Tinkerforge/imu-brick/software/examples/labview/Example Callback.vi.png

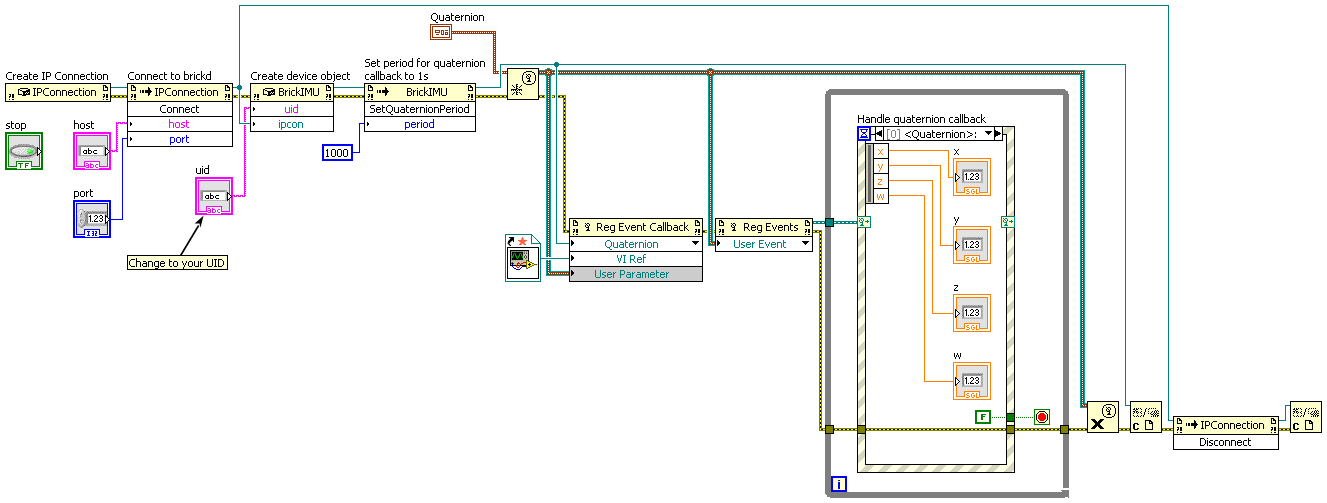
software/examples/labview/Example Callback.vi.png
