Tinkerforge/imu-brick/software/examples/labview/Example Simple.vi.png

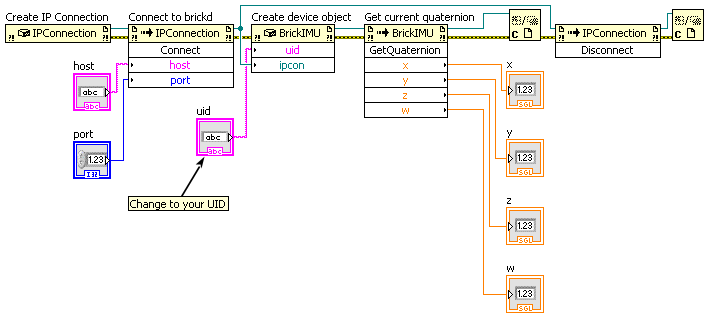
software/examples/labview/Example Simple.vi.png
