Tinkerforge/imu-brick/hardware/imu-schematic.pdf

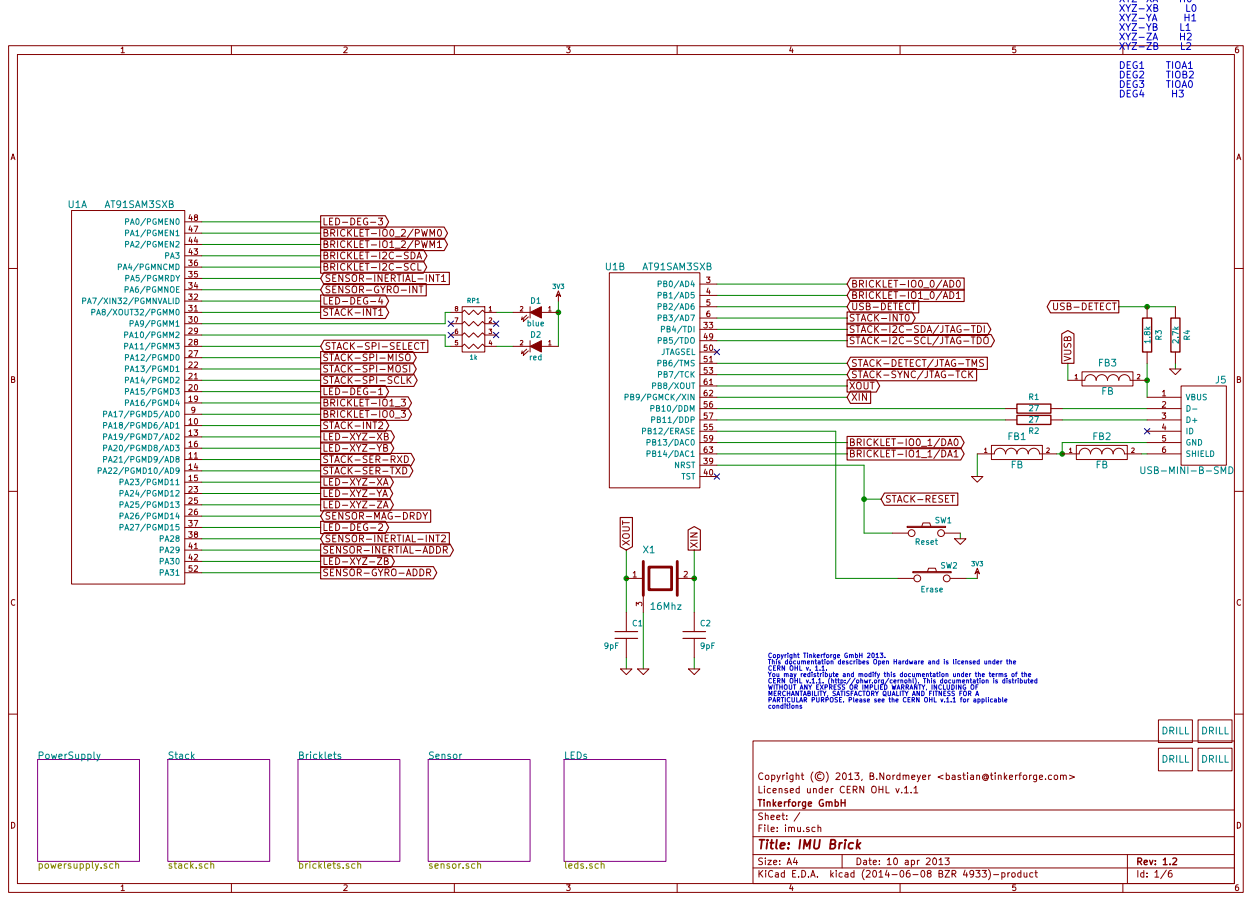
[picture p3: page 1]

XYZ-XA H0 XYZ-XB L0 XYZ-YA H1 XYZ-YB L1 XYZ-ZA H2 XYZ-ZB L2 DEG1 TIOA1

BRICKLET-IO0_2/PWM0 Bricklets bricklets.sch
BRICKLET-IO1_2/PWM1
BRICKLET-I2C-SDA
BRICKLET-I2C-SCL
SENSOR-INERTIAL-INT1
3V3 BRICKLET-IO1_3
SENSOR-GYRO-INT
1k LED-DEG-4

STACK-I2C-SDA/JTAG-TDI
STACK-I2C-SCL/JTAG-TDO

STACK-DETECT/JTAG-TMS
STACK-SYNC/JTAG-TCK
XOUT
XIN

BRICKLET-IO0_3
STACK-INT2
LED-XYZ-XB
LED-XYZ-YB
STACK-SER-RXD
STACK-SER-TXD
LED-XYZ-XA
LED-XYZ-YA
LED-XYZ-ZA
LED-DEG-2
SENSOR-INERTIAL-INT2
leds.sch SENSOR-INERTIAL-ADDR
LED-XYZ-ZB
SENSOR-GYRO-ADDR

Copyright Tinkerforge GmbH 2013. This documentation describes Open Hardware and is licensed under the CERN OHL v. 1.1. You may redistribute and modify this documentation under the terms of the CERN OHL v.1.1. (http://ohwr.org/cernohl). This documentation is distributed WITHOUT ANY EXPRESS OR IMPLIED WARRANTY, INCLUDING OF MERCHANTABILITY, SATISFACTORY QUALITY AND FITNESS FOR A

PARTICULAR PURPOSE. Please see the CERN OHL v.1.1 for applicable
conditions

Licensed under CERN OHL v.1.1 Copyright (©) 2013, B.Nordmeyer <bastian@tinkerforge.com>

File: imu.sch Sheet: / Tinkerforge GmbH

Id: 1/6 Title: IMU Brick

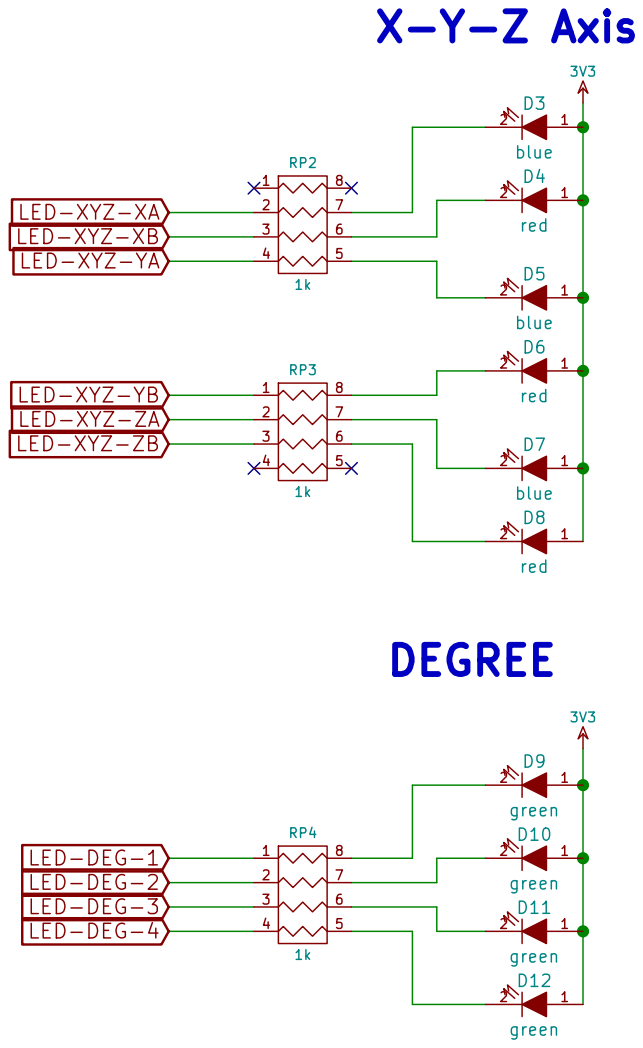
[picture p4: page 2]

Licensed under CERN OHL v.1.1 Copyright (©) 2013, B.Nordmeyer <bastian@tinkerforge.com>

File: leds.sch Sheet: /LEDs/ Tinkerforge GmbH

Id: 2/6 Title: IMU Brick

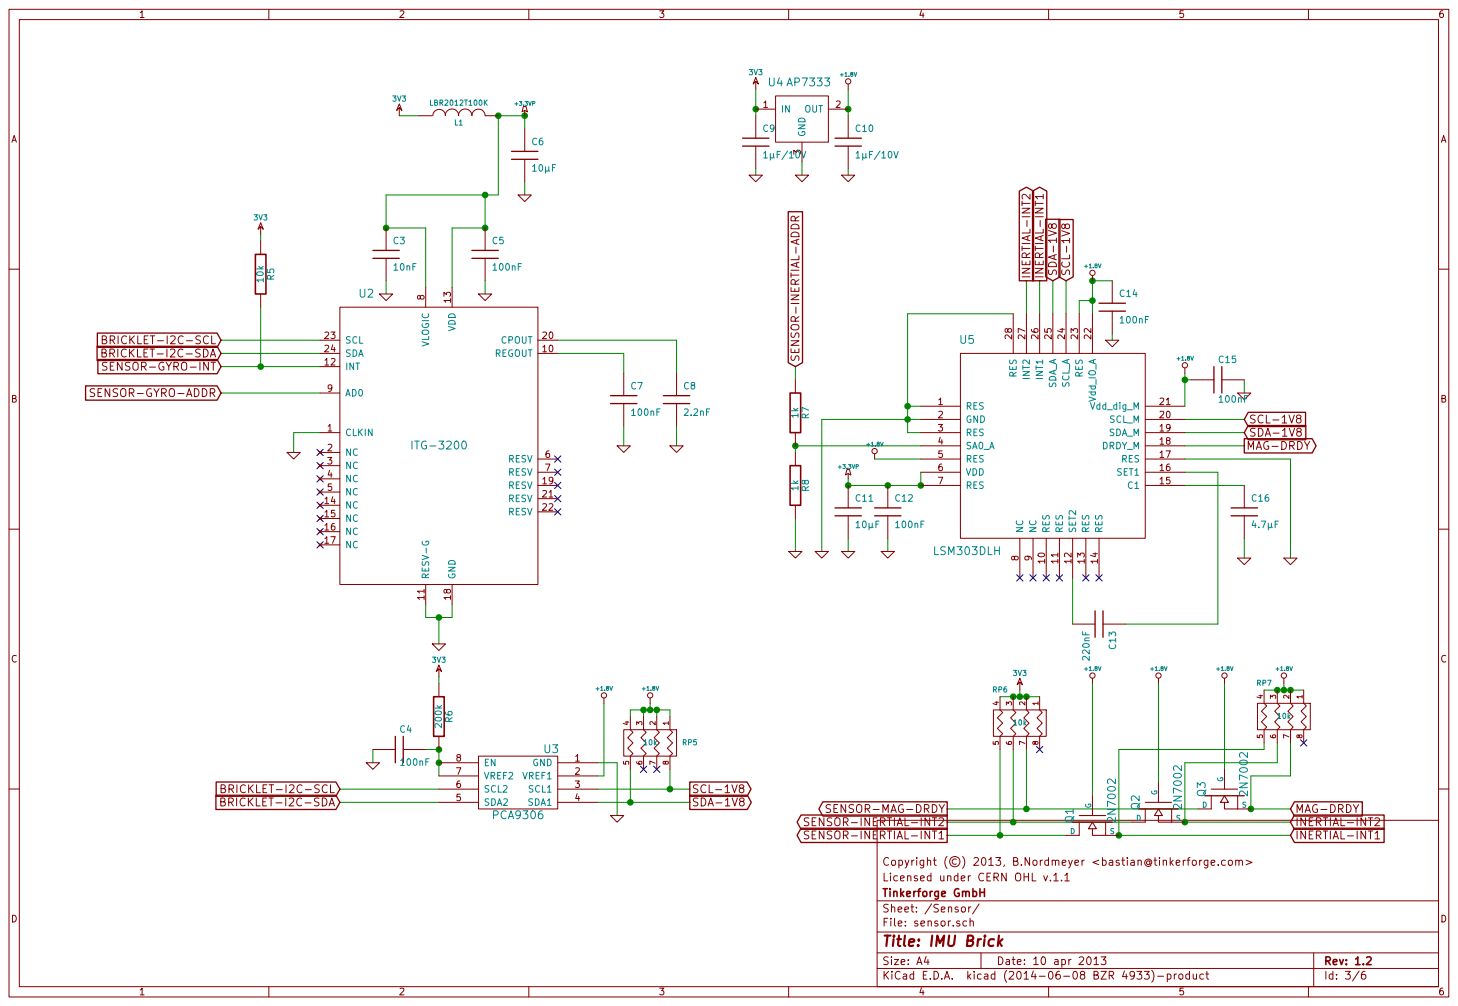
[picture p5: page 3]

8 AD0 9 REGOUT 10 CPOUT 20 RESV-G 11 RESV 21

9 RES 10 SCL_M 20 RES 11 Vdd_dig_M 21 SET2 12 Vdd_IO_A 22 RES 13 RES 23 RES 14 SCL_A 24 C1 15 SDA_A 25 SET1 16 INT1 26 RES 17 INT2 27 DRDY_M 18 RES 28 SDA_M 19 U5

Licensed under CERN OHL v.1.1 Copyright (©) 2013, B.Nordmeyer <bastian@tinkerforge.com>

File: sensor.sch Sheet: /Sensor/ Tinkerforge GmbH

Id: 3/6 Title: IMU Brick

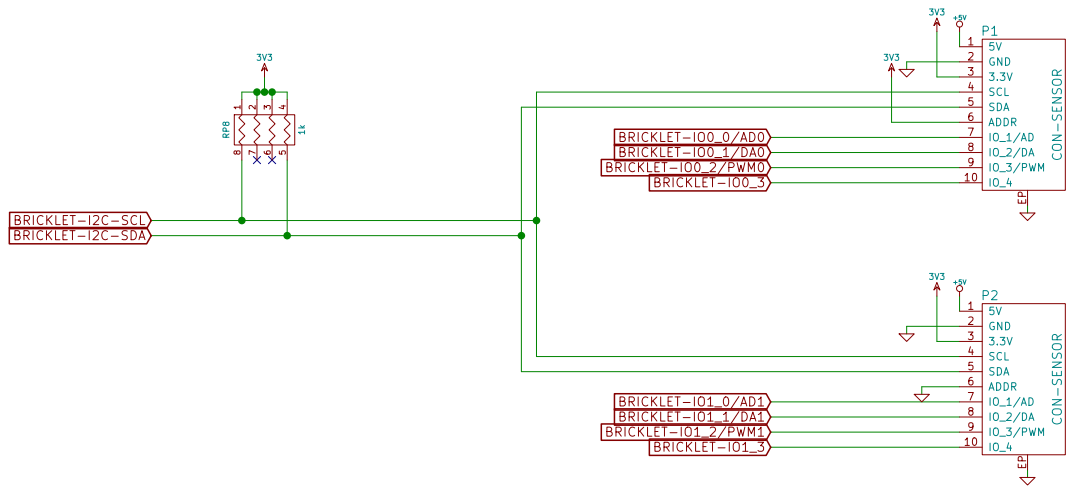
[picture p6: page 4]

File: bricklets.sch Sheet: /Bricklets/ Tinkerforge GmbH

Id: 4/6 Title: IMU Brick

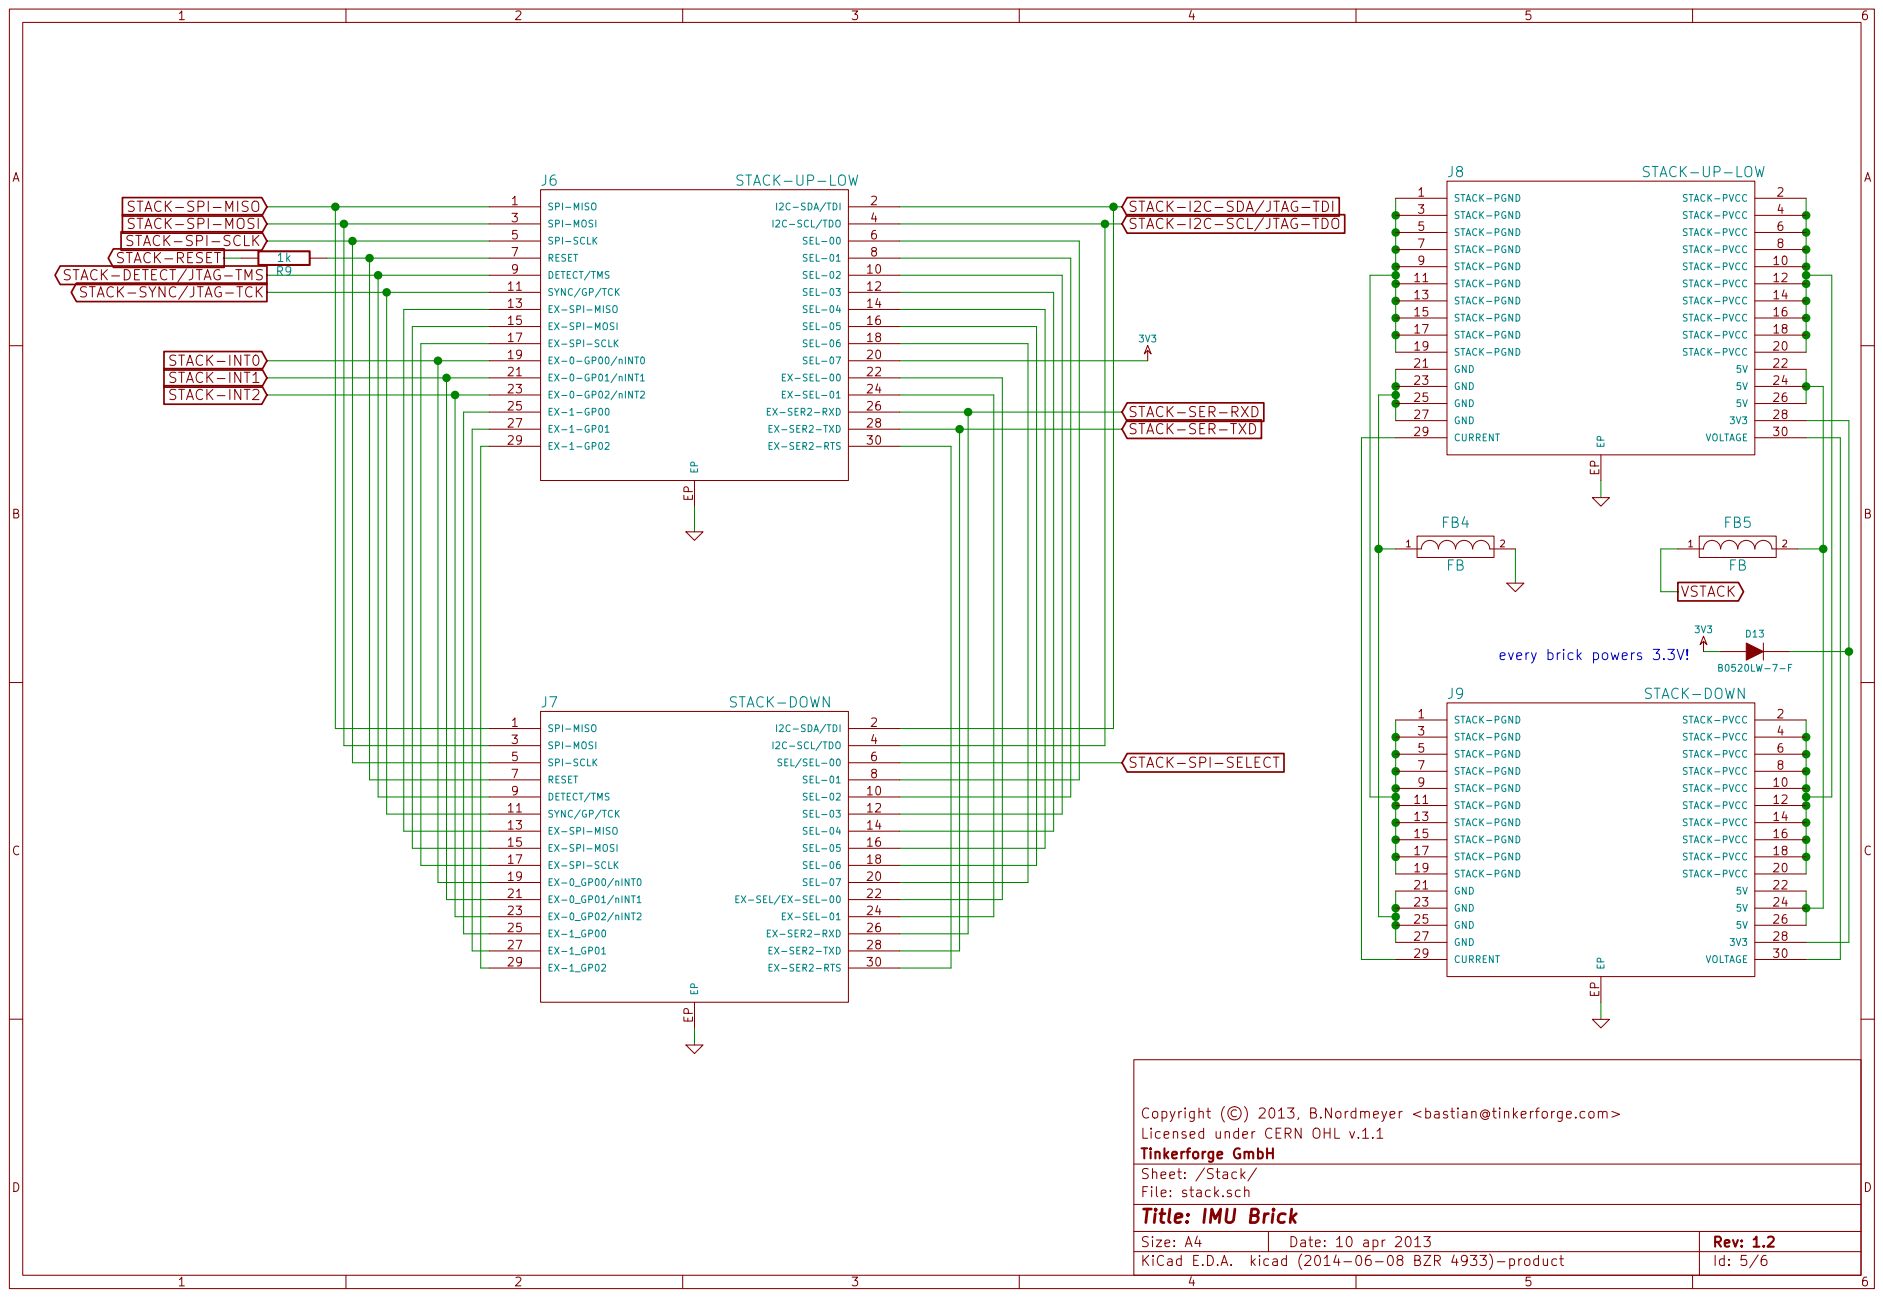
[picture p7: page 5]

STACK-SPI-MISO
STACK-SPI-MOSI
STACK-SPI-SCLK
STACK-RESET
STACK-DETECT/JTAG-TMS
STACK-SYNC/JTAG-TCK

STACK-I2C-SDA/JTAG-TDI
STACK-I2C-SCL/JTAG-TDO

Licensed under CERN OHL v.1.1 Copyright (©) 2013, B.Nordmeyer <bastian@tinkerforge.com>

File: stack.sch Sheet: /Stack/ Tinkerforge GmbH

Id: 5/6 Title: IMU Brick

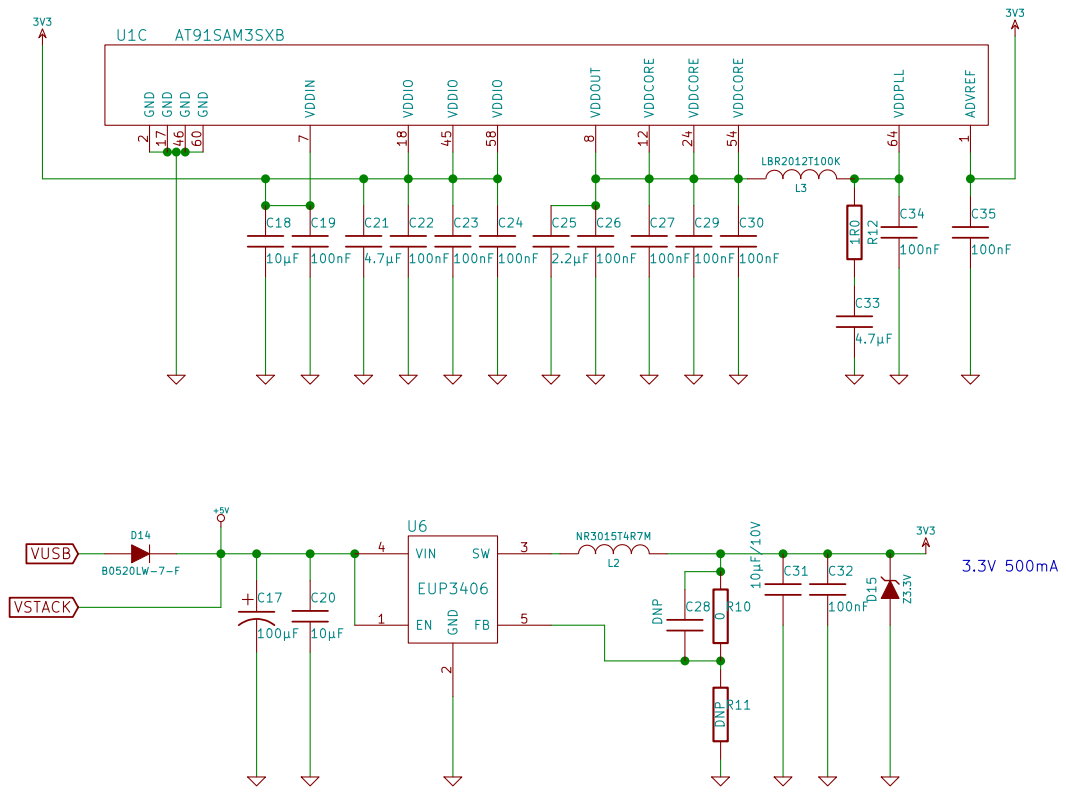
[picture p8: page 6]

8 GND 60 VDDCORE 12 VDDCORE 24 VDDCORE 54 VDDPLL 64 VDDIO 45 GND 46 GND 17 VDDIO 18 VDDIO 58

Licensed under CERN OHL v.1.1 Copyright (©) 2013, B.Nordmeyer <bastian@tinkerforge.com>

Tinkerforge GmbH
Sheet: /PowerSupply/
File: powersupply.sch
Id: 6/6 Title: IMU Brick

D Date: 10 apr 2013
