Tinkerforge/imu-brick/hardware/bricklets.sch

## KiCad design hardware/bricklets.sch (2014-07-07)

Schematic: bricklets.sch

Parts:
P1, P2: CON-SENSOR
RP8: 1k; 0603X4
