Tinkerforge/imu-brick/hardware/imu.sch

## KiCad design hardware/imu.sch (2014-07-07)

Schematic: imu.sch

Parts:
C1, C2: 9pF; 0402
D1: blue; D0603
D2: red; D0603
FB1, FB2, FB3: FB; 0603
J1, J2, J3, J4: DRILL; DRILL_NP
J5: USB-MINI-B-SMD
R1, R2: 27; 0402
R3: 1.8k; 0402
R4: 2.7k; 0402
RP1: 1k; 0603X4
SW1: Reset; TACT-SWITCH
SW2: Erase; TACT-SWITCH
U1: AT91SAM3SXB; LQFP64
X1: 16Mhz; CRYSTAL_3225

Notes on the sheet:
Copyright Tinkerforge GmbH 2013. This documentation describes Open Hardware and is licensed under the CERN OHL v. 1.1. You may redistribute and modify this documentation under the terms of the CERN OHL v.1.1. (http://ohwr.org/cernohl). This documentation is distributed WITHOUT ANY EXPRESS OR IMPLIE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
XYZ-XA H0 XYZ-XB L0 XYZ-YA H1 XYZ-YB L1 XYZ-ZA H2 XYZ-ZB L2 DEG1 TIOA1 DEG2 TIOB2 DEG3 TIOA0 DEG4 H3
