Tinkerforge/imu-brick/hardware/leds.sch

## KiCad design hardware/leds.sch (2014-07-07)

Schematic: leds.sch

Parts:
D3, D5, D7: blue; D0603
D4, D6, D8: red; D0603
D9, D10, D11, D12: green; D0603
RP2, RP3, RP4: 1k; 0603X4

Notes on the sheet:
DEGREE
X-Y-Z Axis
