Tinkerforge/imu-brick/hardware/powersupply.sch

## KiCad design hardware/powersupply.sch (2014-07-07)

Schematic: powersupply.sch

Parts:
C17: 100µF; 3528-21
C18, C20: 10µF; 0805
C19, C22, C23, C24, C26, C27, C29, C30, C32, C34, C35: 100nF; 0402
C21, C33: 4.7µF; 0603
C25: 2.2µF; 0603
C28: DNP; 0402
C31: 10µF/10V; 0805
D14: B0520LW-7-F; SOD-123
D15: Z3.3V; SOD-123
L2: NR3015T4R7M; NR3030
L3: LBR2012T100K; 0805
R10: 0; 0603
R11: DNP; 0603
R12: 1R0; 0402
U1: AT91SAM3SXB
U6: EUP3406; SOT23-5

Notes on the sheet:
3.3V 500mA
