Tinkerforge/imu-brick/hardware/sensor.sch

## KiCad design hardware/sensor.sch (2014-07-07)

Schematic: sensor.sch

Parts:
C3: 10nF; 0402
C4, C5, C7, C12, C14, C15: 100nF; 0402
C6, C11: 10µF; 0805
C8: 2.2nF; 0402
C9, C10: 1µF/10V; 0402
C13: 220nF; 0603
C16: 4.7µF; 0603
L1: LBR2012T100K; 0805
Q1, Q2, Q3: 2N7002; SOT23GDS
R5: 10k; 0402
R6: 200k; 0402
R7, R8: 1k; 0402
RP5, RP6, RP7: 10k; 0603X4
U2: ITG-3200; QFN-24-4x4
U3: PCA9306; TSSOP8_3
U4: AP7333; SOT23-3
U5: LSM303DLH; LGA-28
