Tinkerforge/imu-brick/hardware/stack.sch

## KiCad design hardware/stack.sch (2014-07-07)

Schematic: stack.sch

Parts:
D13: B0520LW-7-F; SOD-123
FB4, FB5: FB; 0603
J6, J8: STACK-UP-LOW; BTB08-ACS-TOP
J7, J9: STACK-DOWN; BTB08-ACS-BTM
R9: 1k; 0402

Notes on the sheet:
every brick powers 3.3V!
