Tinkerforge/imu-brick/software/src/config.h

/* imu-brick
 * Copyright (C) 2010-2012 Olaf Lüke <olaf@tinkerforge.com>
 *
 * config.h: IMU-Brick specific configuration
 *
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
 * You should have received a copy of the GNU Lesser General Public
 * License along with this library; if not, write to the
 * Free Software Foundation, Inc., 59 Temple Place - Suite 330,
 * Boston, MA 02111-1307, USA.
 */

#ifndef CONFIG_H
#define CONFIG_H

#include "communication.h"
#include "bricklib/drivers/board/sam3s/SAM3S.h"

#include "imu.h"

#define BRICK_FIRMWARE_VERSION_MAJOR 2
#define BRICK_FIRMWARE_VERSION_MINOR 3
#define BRICK_FIRMWARE_VERSION_REVISION 9

#define BRICK_HARDWARE_VERSION_MAJOR 1
#define BRICK_HARDWARE_VERSION_MINOR 1
#define BRICK_HARDWARE_VERSION_REVISION 0

#define BRICK_DEVICE_IDENTIFIER 16

// ************** DEBUG SETTINGS **************
#define DEBUG_SPI_STACK 1
#define DEBUG_I2C_EEPROM 1
#define DEBUG_STARTUP 1
#define DEBUG_BRICKLET 1
#define DEBUG_IMU 1
//#define PROFILING
//#define PROFILING_TIME 100 // After how many seconds profiling is printed

#define DISABLE_JTAG_ON_STARTUP
//#define LOGGING_SERIAL
//#define LOGGING_LEVEL LOGGING_DEBUG
#define LOGGING_LEVEL LOGGING_NONE


// ************** BRICK SETTINGS **************

// Frequencies
#define BOARD_MCK      64000000 // Frequency of brick
#define BOARD_MAINOSC  16000000 // Frequency of oscillator
#define BOARD_ADC_FREQ 16000000 // Frequency of ADC
#define BOARD_OSC_EXTERNAL      // Use external oscillator

#define BRICK_HAS_CO_MCU_SUPPORT

// UART for console output (printf)
#define PIN_CONSOLE_RXD  {1 << 21, PIOA, ID_PIOA, PIO_PERIPH_A, PIO_DEFAULT}
#define PIN_CONSOLE_TXD  {1 << 22, PIOA, ID_PIOA, PIO_PERIPH_A, PIO_DEFAULT}

#define CONSOLE_BAUDRATE 115200
#define CONSOLE_USART    USART1
#define CONSOLE_ID       ID_USART1
#define CONSOLE_PINS     {PIN_CONSOLE_RXD, PIN_CONSOLE_TXD}

#define PINS_UART        {PIN_CONSOLE_RXD, PIN_CONSOLE_TXD}

// TWI
// TWI version
#define TWI_V3XX

// TWI stack definitions (for reading of eeproms from Bricks in stack)
#define TWI_STACK           TWI1
#define PIN_TWI_TWD_STACK   {1 << 4, PIOB, ID_PIOB, PIO_PERIPH_A, PIO_DEFAULT}
#define PIN_TWI_TWCK_STACK  {1 << 5, PIOB, ID_PIOB, PIO_PERIPH_A, PIO_DEFAULT}
#define PINS_TWI_STACK      PIN_TWI_TWD_STACK, PIN_TWI_TWCK_STACK

// TWI bricklet definitions (for bricklets, spi select and brick specific
//                           functions)
#define TWI_BRICKLET           TWI0
#define PIN_TWI_TWD_BRICKLET   {1 << 3, PIOA, ID_PIOA, PIO_PERIPH_A, PIO_DEFAULT}
#define PIN_TWI_TWCK_BRICKLET  {1 << 4, PIOA, ID_PIOA, PIO_PERIPH_A, PIO_DEFAULT}
#define PINS_TWI_BRICKLET      PIN_TWI_TWD_BRICKLET, PIN_TWI_TWCK_BRICKLET

// USB
// USB VBUS monitoring pin for USB plug and play
#define PIN_USB_DETECT  {1 << 2, PIOB, ID_PIOB, PIO_INPUT, PIO_DEFAULT}
// USB product descriptor (name of brick)
#define PRODUCT_DESCRIPTOR { \
	USBStringDescriptor_LENGTH(9), \
    USBGenericDescriptor_STRING, \
    USBStringDescriptor_UNICODE('I'), \
    USBStringDescriptor_UNICODE('M'), \
    USBStringDescriptor_UNICODE('U'), \
    USBStringDescriptor_UNICODE(' '), \
    USBStringDescriptor_UNICODE('B'), \
    USBStringDescriptor_UNICODE('r'), \
    USBStringDescriptor_UNICODE('i'), \
    USBStringDescriptor_UNICODE('c'), \
    USBStringDescriptor_UNICODE('k') \
}


// SPI
#define PIN_SPI_MISO        {1 << 12, PIOA, ID_PIOA, PIO_PERIPH_A, PIO_DEFAULT}
#define PIN_SPI_MOSI        {1 << 13, PIOA, ID_PIOA, PIO_PERIPH_A, PIO_DEFAULT}
#define PIN_SPI_SPCK        {1 << 14, PIOA, ID_PIOA, PIO_PERIPH_A, PIO_DEFAULT}

#define PINS_SPI            PIN_SPI_MISO, PIN_SPI_MOSI, PIN_SPI_SPCK

#define PIN_SPI_SELECT_SLAVE  {1 << 11, PIOA, ID_PIOA, PIO_PERIPH_A, PIO_DEFAULT}

// LED
#define PIN_LED_STD_BLUE    {1 << 9, PIOA, ID_PIOA, PIO_OUTPUT_1, PIO_DEFAULT}
#define PIN_LED_STD_RED     {1 << 10, PIOA, ID_PIOA, PIO_OUTPUT_1, PIO_DEFAULT}
#define PINS_STD_LED        PIN_LED_STD_BLUE, PIN_LED_STD_RED

#define LED_STD_BLUE        0
#define LED_STD_RED         1


// Brick Detect
// Set low by master
// TODO: Change name to STACK_DETECT
#define PIN_DETECT        {1 << 6, PIOB, ID_PIOB, PIO_OUTPUT_0, PIO_DEFAULT}



// ************** INTERRUPT PRIORITIES ***********
#define PRIORITY_EEPROM_MASTER_TWI0  1
#define PRIORITY_EEPROM_SLAVE_TWI1   1
#define PRIORITY_STACK_SLAVE_SPI     6
#define PRIORITY_PROFILING_TC0       0

// ************** BRICKLET SETTINGS **************

// Number of bricklet ports
#define BRICKLET_NUM 2

// BRICKLET A
#define BRICKLET_A_ADDRESS 84
#define BRICKLET_A_ADC_CHANNEL 4

#define BRICKLET_A_PIN_1_AD   {1 << 0, PIOB, ID_PIOB, PIO_INPUT, PIO_DEFAULT}
#define BRICKLET_A_PIN_2_DA   {1 << 13, PIOB, ID_PIOB, PIO_INPUT, PIO_DEFAULT}
#define BRICKLET_A_PIN_3_PWM  {1 << 1, PIOA, ID_PIOA, PIO_INPUT, PIO_DEFAULT}
#define BRICKLET_A_PIN_4_IO   {1 << 17, PIOA, ID_PIOA, PIO_INPUT, PIO_DEFAULT}
#define BRICKLET_A_PIN_SELECT {0, 0, 0, 0, 0}

// BRICKLET B
#define BRICKLET_B_ADDRESS 80
#define BRICKLET_B_ADC_CHANNEL 5

#define BRICKLET_B_PIN_1_AD   {1 << 1, PIOB, ID_PIOB, PIO_INPUT, PIO_DEFAULT}
#define BRICKLET_B_PIN_2_DA   {1 << 14, PIOB, ID_PIOB, PIO_INPUT, PIO_DEFAULT}
#define BRICKLET_B_PIN_3_PWM  {1 << 2, PIOA, ID_PIOA, PIO_INPUT, PIO_DEFAULT}
#define BRICKLET_B_PIN_4_IO   {1 << 16, PIOA, ID_PIOA, PIO_INPUT, PIO_DEFAULT}
#define BRICKLET_B_PIN_SELECT {0, 0, 0, 0, 0}

// *************** IMU DEBUGGING **************
#if(DEBUG_IMU)
#define logimud(str, ...) do{logd("imu: " str, ##__VA_ARGS__);}while(0)
#define logimui(str, ...) do{logi("imu: " str, ##__VA_ARGS__);}while(0)
#define logimuw(str, ...) do{logw("imu: " str, ##__VA_ARGS__);}while(0)
#define logimue(str, ...) do{loge("imu: " str, ##__VA_ARGS__);}while(0)
#define logimuf(str, ...) do{logf("imu: " str, ##__VA_ARGS__);}while(0)
#else
#define logimud(str, ...) {}
#define logimui(str, ...) {}
#define logimuw(str, ...) {}
#define logimue(str, ...) {}
#define logimuf(str, ...) {}
#endif
#endif

// *************** IMU LED PINS ***************
#define PIN_LED_X_N  {1 << 19, PIOA, ID_PIOA, PIO_PERIPH_B, PIO_DEFAULT}
#define PIN_LED_X_P  {1 << 23, PIOA, ID_PIOA, PIO_PERIPH_B, PIO_DEFAULT}
#define PIN_LED_Y_N  {1 << 20, PIOA, ID_PIOA, PIO_PERIPH_B, PIO_DEFAULT}
#define PIN_LED_Y_P  {1 << 24, PIOA, ID_PIOA, PIO_PERIPH_B, PIO_DEFAULT}
#define PIN_LED_Z_N  {1 << 25, PIOA, ID_PIOA, PIO_PERIPH_B, PIO_DEFAULT}
#define PIN_LED_Z_P  {1 << 30, PIOA, ID_PIOA, PIO_PERIPH_A, PIO_DEFAULT}

#define PINS_LED_XYZ   PIN_LED_X_P, PIN_LED_X_N, PIN_LED_Y_P, \
                       PIN_LED_Y_N, PIN_LED_Z_P, PIN_LED_Z_N

#define PIN_LED_DEG_0  {1 << 15, PIOA, ID_PIOA, PIO_PERIPH_B, PIO_DEFAULT}
#define PIN_LED_DEG_1  {1 << 27, PIOA, ID_PIOA, PIO_PERIPH_B, PIO_DEFAULT}
#define PIN_LED_DEG_2  {1 << 0, PIOA, ID_PIOA, PIO_PERIPH_B, PIO_DEFAULT}
#define PIN_LED_DEG_3  {1 << 7, PIOA, ID_PIOA, PIO_PERIPH_B, PIO_DEFAULT}

#define PINS_LED_DEG   PIN_LED_DEG_0, PIN_LED_DEG_1, \
                       PIN_LED_DEG_2, PIN_LED_DEG_3

#define PINS_IMU_LED   PINS_LED_XYZ, PINS_LED_DEG
#define PINS_LED       PINS_STD_LED, PINS_IMU_LED

#define LED_X_P      0
#define LED_X_N      1
#define LED_Y_P      2
#define LED_Y_N      3
#define LED_Z_P      4
#define LED_Z_N      5

#define LED_DEG_0    6
#define LED_DEG_1    7
#define LED_DEG_2    8
#define LED_DEG_3    9

// *************** ITG-3200 PINS ***************
#define PIN_ITG_ADDR     {1 << 31, PIOA, ID_PIOA, PIO_OUTPUT_0, PIO_DEFAULT}
#define PIN_ITG_INT      {1 << 6, PIOA, ID_PIOA, PIO_INPUT, PIO_DEFAULT}

#define PINS_ITG         PIN_ITG_ADDR, PIN_ITG_INT

// *************** LSM303 PINS *****************
#define PIN_LSM_ADDR     {1 << 29, PIOA, ID_PIOA, PIO_OUTPUT_0, PIO_DEFAULT}
#define PIN_LSM_INT1     {1 << 5, PIOA, ID_PIOA, PIO_INPUT, PIO_DEFAULT}
#define PIN_LSM_INT2     {1 << 28, PIOA, ID_PIOA, PIO_INPUT, PIO_DEFAULT}
#define PIN_LSM_MAG_RDY  {1 << 26, PIOA, ID_PIOA, PIO_INPUT, PIO_DEFAULT}

#define PINS_LSM         PIN_LSM_ADDR, PIN_LSM_INT1, \
                         PIN_LSM_INT2, PIN_LSM_MAG_RDY

#define TWI_IMU          TWI0


// *************** Stack interrupt pins *********
#define PIN_STACK_INT0   {1 << 3, PIOB, ID_PIOB, PIO_INPUT, PIO_DEFAULT}
#define PIN_STACK_INT1   {1 << 8, PIOA, ID_PIOA, PIO_INPUT, PIO_DEFAULT}
#define PIN_STACK_INT2   {1 << 18, PIOA, ID_PIOA, PIO_INPUT, PIO_DEFAULT}

#define PINS_STACK       PIN_STACK_INT0, PIN_STACK_INT1, PIN_STACK_INT2
