Tinkerforge/imu-brick/(commit log)

2012-03-02 Use quaternion instead of magnetometer for direction leds
2012-03-05 Fix bug with timeouts on windows (through bricklib)
    [config.h]
2012-03-11 Fix bug with ADC calibration readout (through bricklib)
    [config.h]
2012-05-31 Add imu calibration software (magnetometer code still missing)
    [calibration.py]
2012-06-03 Repair wrong defines (see issue #1 on github)
    [imu.h]
2012-06-03 Change IMU Brick version to 1.0.5
2012-06-29 Add get_temperature and reset function (through bricklib)
    [config.h]
2012-07-13 Fix profiling (bricklib issue #2)
    [imu.c]
2012-09-20 Set Interrupt pins to input default (otherwise they can interfere with WIFI)
    [calibration.py, config.h, main.c]
2012-11-30 Fix compile error in last commit
    [communication.c]
2013-01-07 Use portEND_SWITCHING_ISR to return from interrupt
2013-01-09 Use specific device object for callbacks
2013-04-11 Convert IMU calibration scripts to protocol v2
2013-04-11 Add watchdog timer (restart after 16s of "deadlock")
2013-05-13 Add orientation calculation on/off API, make i2c communication synchronous
2013-06-27 Use tick_task to detect usb connect/disconnect instead of interrupt (through bricklib)
2014-04-02 perl: Unify print style
2014-06-12 change voltage divider resistor values
    [bricklets.sch, imu.brd, imu.sch, leds.sch, powersupply.sch, sensor.sch, stack.sch]
2014-09-25 Add SPI DMA defines
2014-11-25 Use new SPI protocol
2015-05-13 Implement set/get acceleration/magnetometer range
2015-06-22 matlab: Unify printing style in examples
2015-08-07 Use full device class name in Python examples
2016-01-13 Saving of calibration currently only on sam3s
    We added support for the sam4s processor family to bricklib, saving the
    calibration to the flash is currently not possible with the old code. We just
    remove it for sam4s for now (we will fix it if there actually is a IMU Brick with the sam4s)
    [imu.c]
2016-05-18 c: Add missing device destroy call
2016-12-05 Add ringbuffer and system timer utility as well as co_mcu support files to Makefile (all added through bricklib)
2018-01-11 Increase version number (message duplication bug fix through bricklib)
    [config.h]
2018-02-20 Cleanup KiCad libraries config
    Ensure LibDir=kicad-libraries and LibName1=tinkerforge.
    Remove special library.
2021-10-25 Update KiCad link
    https://www.kicad.org/blog/2021/10/Avoid-links-to-former-kicad-domain/
