Tinkerforge/imu-brick/(notices)

Notices in the files:
software/calibration/calibration.py:
modify it under the terms of the GNU General Public License
